ri-ru/microcontroller-greenhouse/(commit log)

2026-05-22 Initial commit: AVR assembly microcontroller project
2026-05-25 RC5 decoder as INT7 ISR; main.asm wires it up; report draft
2026-05-25 Map RC5 buttons to Vivanco UR Z2 codes; AS7 added all .asm files to project tree
2026-05-25 RC5: filter auto-repeat via toggle bit; let POWER exit SET mode
2026-05-25 Debug: show last RC5 code on LCD for button-code capture
2026-05-25 Scaffold main.asm for R's temp ISR: Timer0 vector+init, wire1 hooks, overflow0 stub
2026-05-25 Integrate temp ISR + LCD line-split + dirty-flag throttling
    - overflow0 now contains R's temp-read + PRINTF on line 1, plus a
    working version of the threshold-driven window control (her original
    had two nop;rcall lines and a garbage T-flag check).
    - main loop redraws line 2 only when state changes (lcd_dirty flag),
    so the constant LCD writes don't race the ISR's line-1 writes.
    - Fix Timer0 prescaler: TCCR0=5 (~1 Hz) instead of TCCR0=1 (~128 Hz).
    Wrong value was starving the RC5 ISR.
    - Dispatchers switched to _JK (long-range rjmp) since overflow0 pushed
    some JK targets past the breq ±63-instruction window.
    - POWER now exits SET to SLEEP (UX fix).
    - Report + changelog updated.
    [main.asm]
2026-05-25 Restore R's reset init order (TIMSK->ASSR->TCCR0->sei->b3:b2->convertT)
    [main.asm]
2026-05-25 Move library includes before reset: so PRINTF/LCD macros are defined when splash uses them
    [main.asm]
2026-05-25 Fix: preserve temp across PRINTF in overflow0 (window now reacts to target changes); add periods to line 2
    [main.asm]
2026-05-25 REPORT: fix stale info (TCCR0=5, Temp: format, drop wire1_temp2 from modules); fill servo section
2026-05-25 Swap LCD lines: state info on top, temp on bottom
    [main.asm]
2026-05-25 Add 3-min French video script for project demo
    Covers NORMAL/SET/SLEEP demos, technical highlights, and
    shooting tips. Aligned with current SLEEP behavior (2s splash
    then LCD off, ISR no-op).
2026-05-25 SLEEP just clears LCD instead of turning display off (simpler, no wake-stuck issues)
    [main.asm]
2026-05-25 Extract open_window/close_window into servo.asm (R will fill PWM here)
2026-05-25 Split main.asm into thermo.asm (Timer0 ISR) and display.asm (LCD refresh + splash)
2026-05-25 Docs: update REPORT/CHANGES/video_script for thermo+display+servo module split
2026-05-25 Add servo_explain.md: high-level architecture overview for R
2026-05-25 Add for_R.md: hand-off note to R explaining the refactor + servo task
2026-05-25 Fix wake-from-SLEEP splash: cpi before STI clobbers w
    STI expands to "ldi w, k ; sts addr, w", so the two STIs after
    "lds w, mode_var" overwrote w with the literal 1, making the
    "cpi w, MODE_SLEEP" always fail and skipping do_splash on wake.
    Move the cpi up; ldi/sts leave SREG untouched, so the Z flag
    survives across the STIs.
    [main.asm]
2026-05-25 Add EEPROM-backed min/max history with HISTORY mode
    New eeprom.asm: internal EEPROM driver + history_init/update routines.
    GUIDE button (KEY_HIST=0x22) toggles a new HISTORY mode displaying
    min/max persisted across power cycles (5 bytes EEPROM, magic-protected).
    to_normal restructured: from HISTORY, do LCD_clear so the leftover
    "Max:" doesn't linger on line 2 until the next Timer0 tick.
    [display.asm, eeprom.asm, main.asm, thermo.asm]
2026-05-25 Add diagrams.md: per-routine flowchart source for report figures
2026-05-25 Merge R's servo PWM + convertT_ended flag with EEPROM history
    Re-applies the EEPROM-backed min/max history (commit 947c8cb) that was
    overwritten by the upload, and keeps R's new servo PWM implementation
    plus the convertT_ended flag (relocated to 0x026b to avoid colliding
    with min_temp/max_temp at 0x0267/0x0269).
    [main.asm]
2026-05-25 Revert main.asm and servo.asm to 082e47e (last working IR)
    R's blocking servo PWM from 4fd4ecf was being called from inside the
    Timer0 ISR (overflow0) on temperature threshold transitions, leaving
    interrupts disabled for ~260ms each time. INT7 (IR) could not fire
    during that window, so RC5 frames were either lost or sampled
    mid-frame and decoded as garbage codes that matched no key.
    Going back to the stub open_window/close_window for now. R's PWM can
    be reintroduced once the servo call is deferred out of the Timer0
    ISR (e.g. set a window_pending flag, call from main loop).
    [main.asm, servo.asm]
2026-05-25 Defer temp work out of Timer0 ISR so servo PWM doesn't block IR
    Finishes R's convertT_ended flag pattern (started on the stuff branch
    but left half-wired). Timer0 ISR (overflow0) is now just a flag-setter;
    the actual DS18B20 read + LCD line 2 + history_update + servo control
    runs as readT, called from the main loop when the flag is set.
    This lets open_window/close_window do their 13x20ms blocking PWM
    without masking INT7, so RC5 keeps decoding correctly during a window
    movement. Also adds the DDRC bit for SERVO1 so PC4 actually drives the
    servo (R's PWM wrote to PORTC.4 while DDRC.4 was input -> nothing).
    [main.asm, servo.asm, thermo.asm]
2026-05-25 Servo on PORTF (PORTC is the external SRAM address bus), fix far breq
    Two fixes:
    - PORTC is taken by the external memory interface (SRE bit in MCUCR,
    needed for the LCD). Writing to PORTC.4 corrupted the address bus,
    which locked the LCD inside readT's PRINTF. Servo now on PORTF.
    Note: PF4 is JTAG TCK by default, JTAGEN fuse must be off.
    - readT was too long for breq to reach rt_done across the PRINTF .db
    block. Inverted those two branches and used rjmp.
    [main.asm, servo.asm, thermo.asm]
2026-05-25 TP10-style servo PWM in main loop, PORTF.SERVO1 via lds/sts
    Replaces R's blocking 13-pulse open_window/close_window with the TP10
    pattern (cf. servo1.asm in docs/TP10): one PWM cycle per main-loop
    iteration, pulse width selected from window_open (1.9 ms open, 1.52 ms
    closed). open_window/close_window are back to stubs that flip
    window_open + lcd_dirty; the next main-loop iteration moves the servo.
    PORTF is the only port left for GPIO since PORTA/PORTC are eaten by the
    external SRAM bus (SRE). PORTF sits in extended I/O (>0x3F), so
    sbi/cbi/in/out are not allowed -- using OUTEI for init and lds/sts for
    the per-cycle pin toggling. PF4 also needs JTAGEN fuse off.
    Since the servo is no longer d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
    [main.asm, servo.asm]
2026-05-25 Use OUTEI for PORTF PWM toggles (SERVO1 seul bit utilise)
2026-05-25 Skip window regulation in SET mode (no twitch while editing consigne)
    [thermo.asm]
2026-05-25 Revert "Skip window regulation in SET mode (no twitch while editing consigne)"
    This reverts commit 2809cb1cf3025c2de3ef198d90be21adc8a43332.
    [thermo.asm]
2026-05-25 Fix startup window flip-flop: real temp ready for first readT
    Two cooperating fixes:
    - Start the first convertT BEFORE the splash, so the 750 ms conversion
    finishes during the 2 s splash. The DS18B20 scratchpad now contains a
    real reading by the time main loop runs (instead of the 0x0550 = 85.0C
    power-on default that triggered a spurious open).
    - Clear TIFR.TOV0 between configuring AS0 and enabling TOIE0. Setting
    AS0 can spuriously set the overflow flag (ATmega128 errata), and if
    TOIE0 is already enabled the ISR fires immediately on sei.
    [main.asm]
2026-05-25 Revert "Fix startup window flip-flop: real temp ready for first readT"
    This reverts commit 7be71aaf970b8ff5b41669329983475d357689a2.
    [main.asm]
2026-05-26 Update video script: add HISTORY/EEPROM section and deferred-ISR note
    Reflects the features added since the script was last revised:
    - 4th mode HISTORY (GUIDE button, min/max from EEPROM)
    - EEPROM persistence of extremes across power-off
    - Architectural change: Timer0 ISR only sets convertT_ended flag,
    readT runs from main loop so servo PWM doesn't mask INT7
    - TP10-style PWM in main loop (mentioned in technical points)
    Rebalanced section timings to fit HISTORY demo while staying under 3 min.
2026-06-06 Flatten project to repo root; stop tracking report .tex
    Move the Atmel Studio solution, project and .asm sources out of the
    doubly-nested Projet_Microcontrolleurs/Projet_Microcontrolleurs/ folder
    into the repo root and fix the .atsln project path. Remove the personal
    report MCU2026-G118.tex from version control (kept locally, gitignored).
    [display.asm, eeprom.asm, ir_rc5.asm, main.asm]
